killadog/S88-feedback-module/(list of files, drawings)

Other design files:
AS88_V1.1.lay
