killadog/S88-feedback-module/RB-S88_V2.ino

/*
S88 occupancy sensor interface to Command Station (in my case an ESU ECoS2)

Software by Ruud Boer, November 2014.
Freely distributable for private, non commercial, use.

Connections for S88 bus:
s88 pin 1 Data - Arduino pin 13 = Data_Out to Oommand Station, or to the previous Arduino in the chain
s88 pin 2 GND  - Arduino GND
s88 pin 3 Clock - Arduino pin 2, interrupt 0
s88 pin 4 PS - Arduino pin 3, interrupt 1
S66 pin 5 Reset (not used here) - Arduino pin 12, used as DATA IN from previous Arduino DATA OUT
s88 pin 6 V+ - Arduino 5V

IMPORTANT: To avoid S88 signals to jitter, it is best to put DATA_in pin 12 to GND on the last Arduino in the chain.

Connections for sensors: see table in void Setup() at line 35.
REMARK1: Inputs have the internal pullup resistor active, the sensors must pull the input to GND.
REMARK2: How short a pulse is allowed from the sensors before it is not seen?
A test showed that the main loop where all sensors are read runs once every 76 microseconds.
If a train runs over the reed switch with a speed of 1m/s, which is over 300 km/hr, that translates to 1 mm/ms.
So even if the reed switch would be on only for a 1 mm travel distance, then still the Arduino
will read that info more than 10 times!

*/

int clockCounter=0;
long loopCounter=0; //used in lines 55 and 88, see there for explanation
unsigned int sensors=0;
unsigned int data=0xffff;
const byte dataIn=12;  //data input from next Arduino in S88 chain
const byte dataOut=13; //data output pin=13
boolean loadSensors=false; //flag that says to load sensor bits into dataOut bits

void setup() {
  pinMode(2, INPUT);
  attachInterrupt(0,clock,RISING); //pin 2 = clock interrupt
  pinMode(3, INPUT);
  attachInterrupt(1,PS,RISING);    //pin 3 = PS interrupt
  pinMode(dataIn,INPUT); //pin 12 = data in from next Arduino S88 in chain
  pinMode(dataOut, OUTPUT); //pin 13 = data out to z21 or to previous Arduino in S88 chain
  digitalWrite(dataOut, LOW);   //LED off
  pinMode(A0, INPUT); //sensor 01
  pinMode(A1, INPUT); //sensor 02
  pinMode(A2, INPUT); //sensor 03
  pinMode(A3, INPUT); //sensor 04
  pinMode(A4, INPUT); //sensor 05
  pinMode(A5, INPUT); //sensor 06
  pinMode(A6, INPUT); //sensor 07
  pinMode(A7, INPUT); //sensor 08
  pinMode(4, INPUT);  //sensor 09
  pinMode(5, INPUT);  //sensor 10
  pinMode(6, INPUT);  //sensor 11
  pinMode(7, INPUT);  //sensor 12
  pinMode(8, INPUT);  //sensor 13
  pinMode(9, INPUT);  //sensor 14
  pinMode(10, INPUT); //sensor 15
  pinMode(11, INPUT); //sensor 16
}

void loop() {
  if (loopCounter==600){bitSet(sensors,0);}
  /*
  For an unknown reason the ECoS sets the first 8 bits to 1 after startup / reset of the S88 Arduino's.
  When one of the sensor inputs is changed, from there on everything goes well.
  Therefore, over here we give sensor bit 0 an automatic change after 30 seconds, when the ECoS is fully started.
  The 1 second is created via 'loopCounter', which increments in the PS interrupt (line 88).
  There are appr0ximately 20 PS pulses per second, therefore we use 20x30=600 in the if statement.
  */
  if (!digitalRead(A0)) {bitSet(sensors,0);}
  if (!digitalRead(A1)) {bitSet(sensors,1);}
  if (!digitalRead(A2)) {bitSet(sensors,2);}
  if (!digitalRead(A3)) {bitSet(sensors,3);}
  if (!digitalRead(A4)) {bitSet(sensors,4);}
  if (!digitalRead(A5)) {bitSet(sensors,5);}
  if (!digitalRead(A6)) {bitSet(sensors,6);}
  if (!digitalRead(A7)) {bitSet(sensors,7);}
  if (!digitalRead(4)) {bitSet(sensors,8);}
  if (!digitalRead(5)) {bitSet(sensors,9);}
  if (!digitalRead(6)) {bitSet(sensors,10);}
  if (!digitalRead(7)) {bitSet(sensors,11);}
  if (!digitalRead(8)) {bitSet(sensors,12);}
  if (!digitalRead(9)) {bitSet(sensors,13);}
  if (!digitalRead(10)) {bitSet(sensors,14);}
  if (!digitalRead(11)) {bitSet(sensors,15);}
}

void PS() {
  clockCounter=0;
  data=sensors;
  sensors=0;
  loopCounter++; //Increment loopCounter to cretae a timer. See line 55 for explanation.
}

void clock() {
  digitalWrite(dataOut,bitRead(data,clockCounter));
  delayMicroseconds(16); //Delay makes reading output signal from next Arduino in chain more reliable.
  bitWrite(data,clockCounter,digitalRead(dataIn));
  clockCounter =(clockCounter +1) % 16;
}
